lukasz-strama/jitter-daq/docs/jitter-hw.png

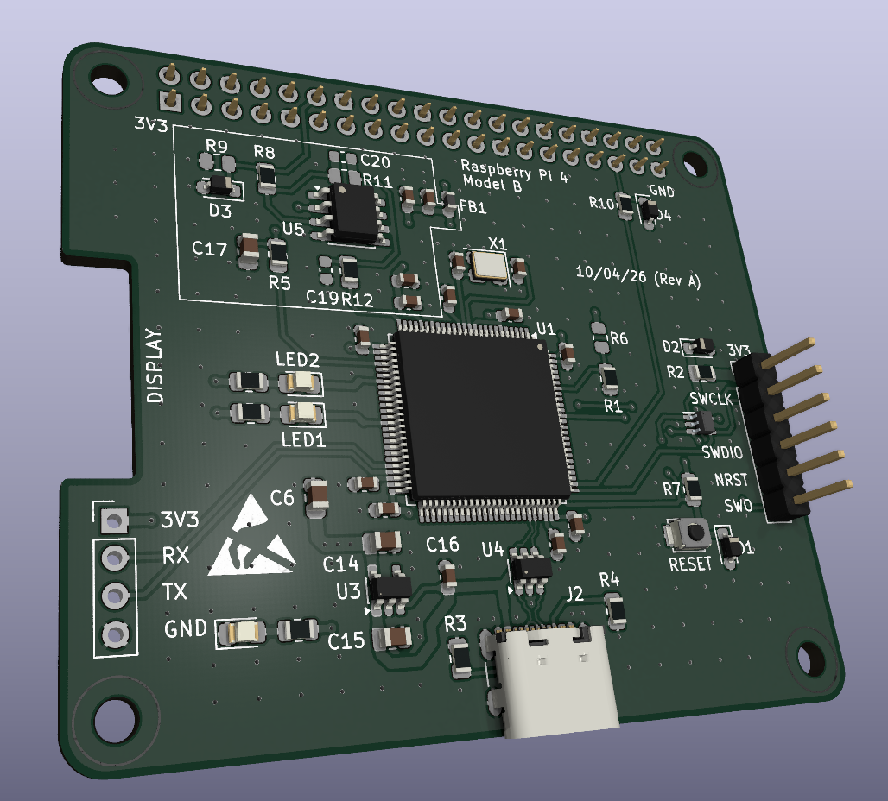
docs/jitter-hw.png
