lukasz-strama/jitter-daq/step/RF2-143-T-17-50-G.STEP

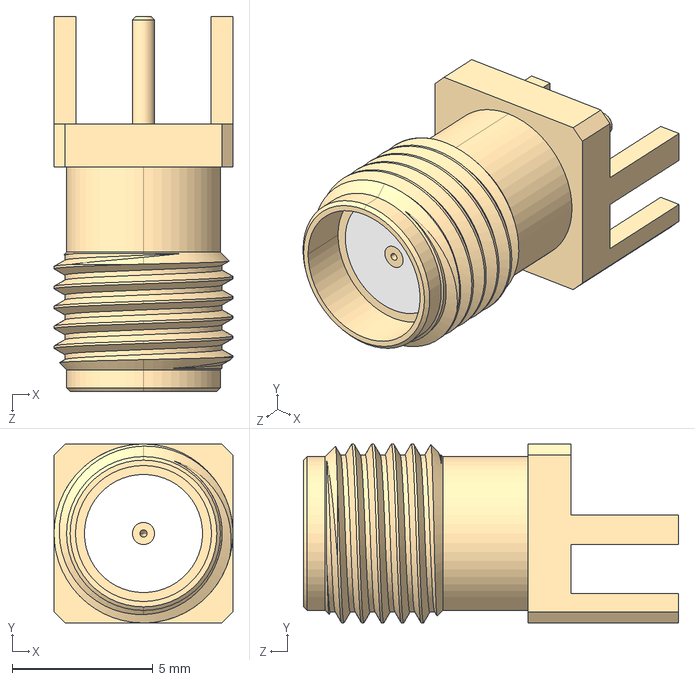
[picture p2: CAD file, 2026-10-07]
step/RF2-143-T-17-50-G.STEP
6.35 x 6.35 x 13.3 mm
