lukasz-strama/jitter-daq/step/ESDALC6V1W5.stp

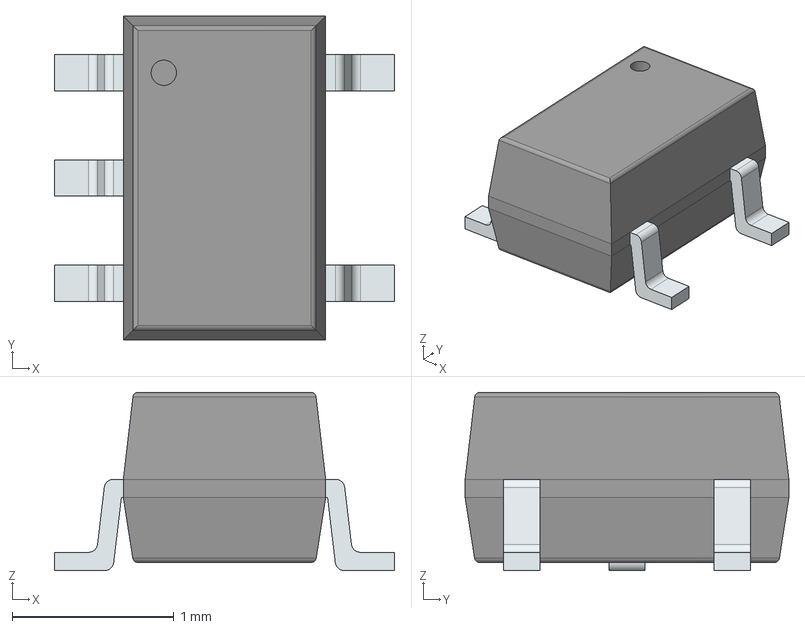
[picture p3: CAD file, 2026-10-07]
step/ESDALC6V1W5.stp
2.10 x 2.00 x 1.10 mm
PinsArrayL
PinsArrayR
