lukasz-strama/jitter-daq/docs/jitter-hw.pdf

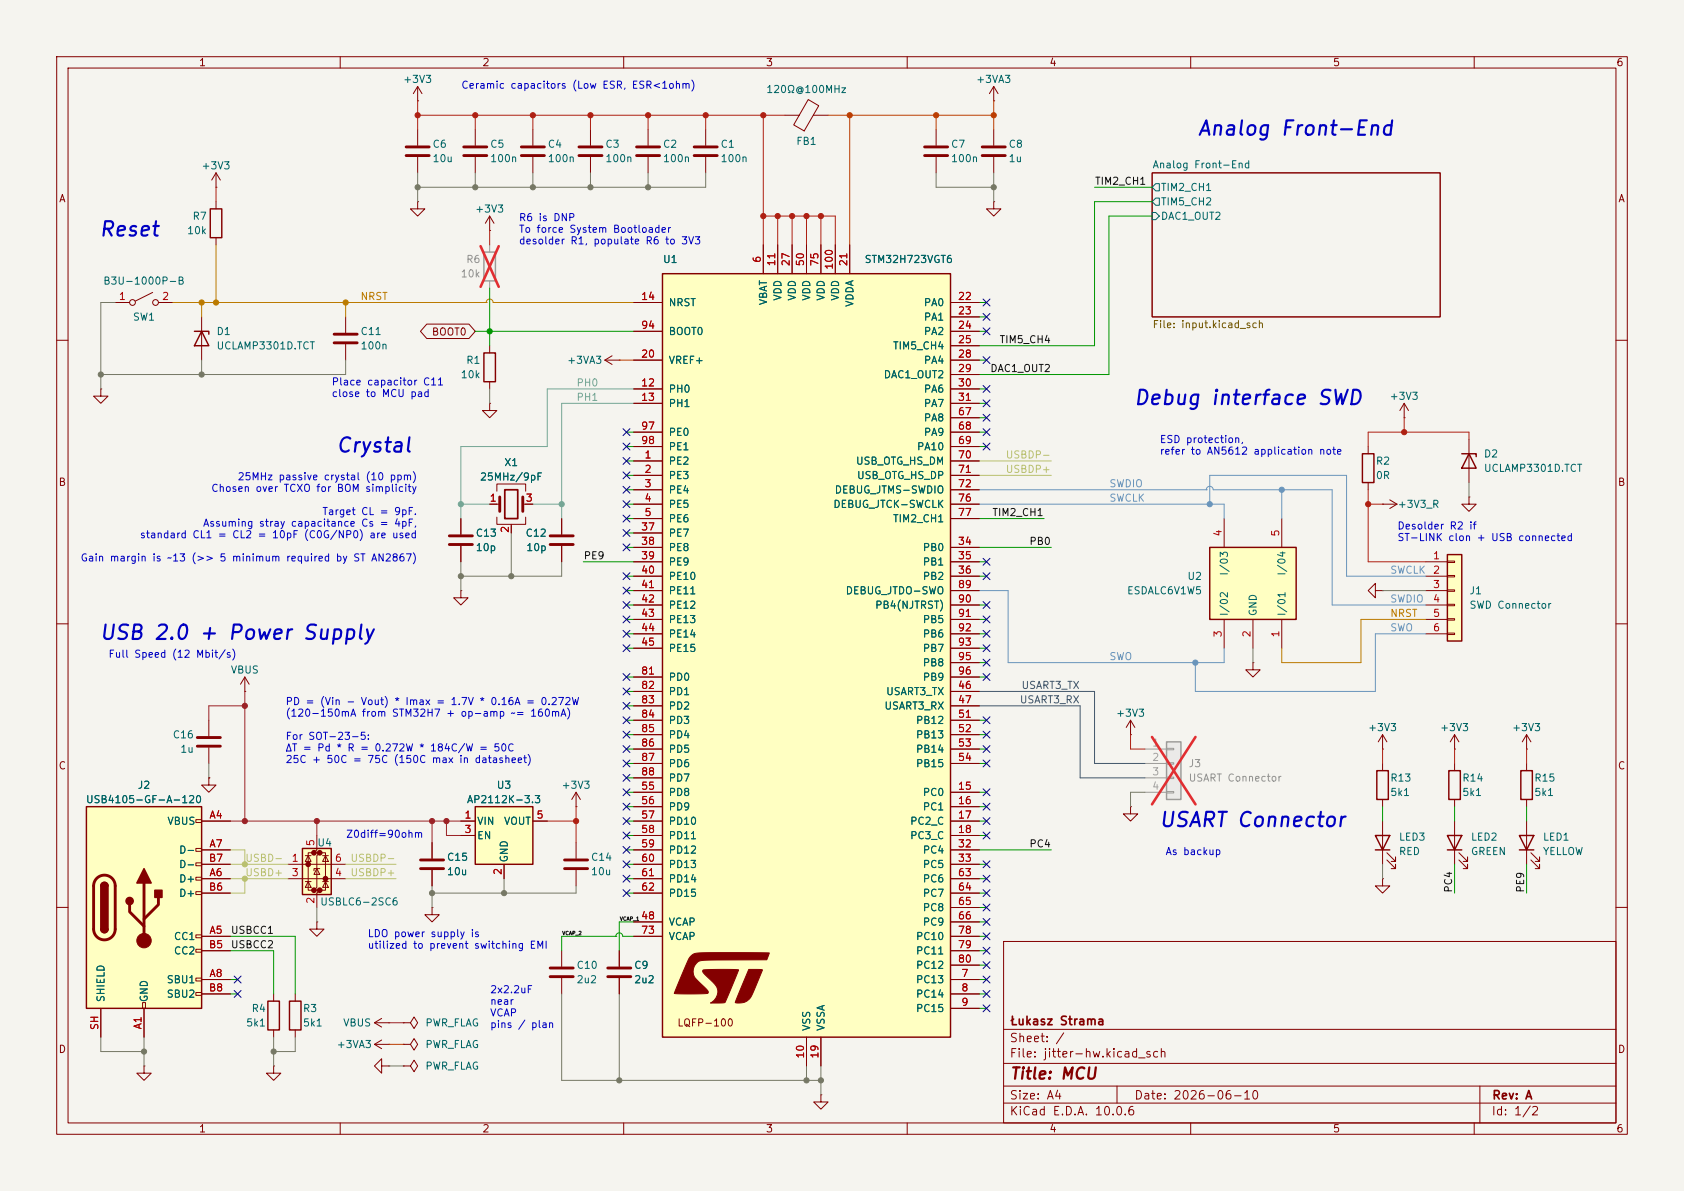
[picture p4: page 1]

Ceramic capacitors (Low ESR, ESR<1ohm)

To force System Bootloader desolder R1, populate R6 to 3V3 Place capacitor C11

25C + 50C = 75C (150C max in datasheet) 25MHz passive crystal (10 ppm) Chosen over TCXO for BOM simplicity

PD = (Vin - Vout) * Imax = 1.7V * 0.16A = 0.272W
(120-150mA from STM32H7 + op-amp ~= 160mA) For SOT-23-5: ΔT = Pd * R = 0.272W * 184C/W = 50C

Size: A4 | Rev: A
KiCad E.D.A. 10.0.6 | Id: 1/2

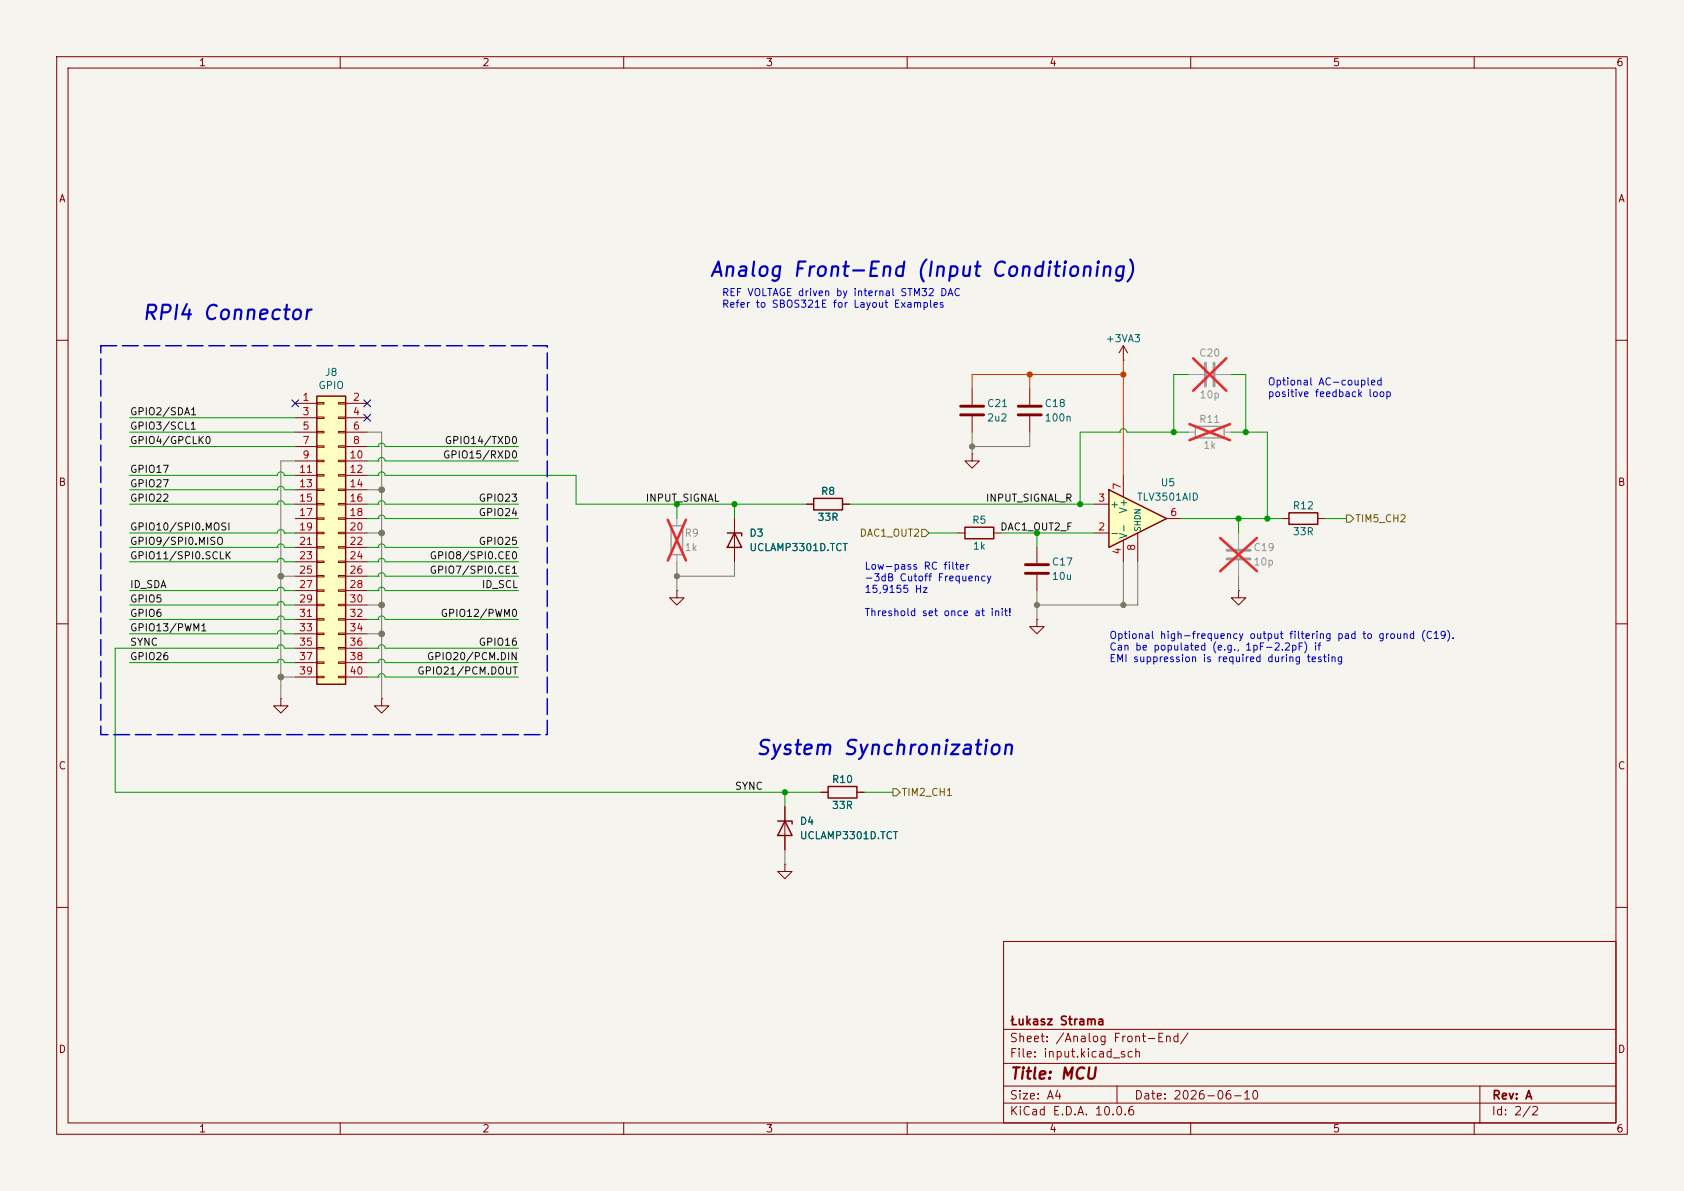
[picture p5: page 2]

Analog Front-End (Input Conditioning)

REF VOLTAGE driven by internal STM32 DAC
D3UCLAMP3301D.TCT R10

Refer to SBOS321E for Layout Examples RPI4 Connector

11 | 12
13 | 14
15 | 16

GPIO21/PCM.DOUT GPIO24 GPIO25 GPIO20/PCM.DIN

21 | 22
23 | 24
25 | 26
27 | 28
29 | 30
31 | 32
33 | 34
35 | 36
37 | 38
39 | 40

Low-pass RC filter -3dB Cutoff Frequency

Threshold set once at init! System Synchronization

Optional high-frequency output filtering pad to ground (C19). Can be populated (e.g., 1pF-2.2pF) if EMI suppression is required during testing

Łukasz Strama
Sheet: /Analog Front-End/
File: input.kicad_sch
Title: MCU

Size: A4 | Rev: A
KiCad E.D.A. 10.0.6 | Id: 2/2
