lukasz-strama/jitter-daq/jitter-hw.kicad_pcb

## KiCad design jitter-hw.kicad_pcb (2026-10-13)

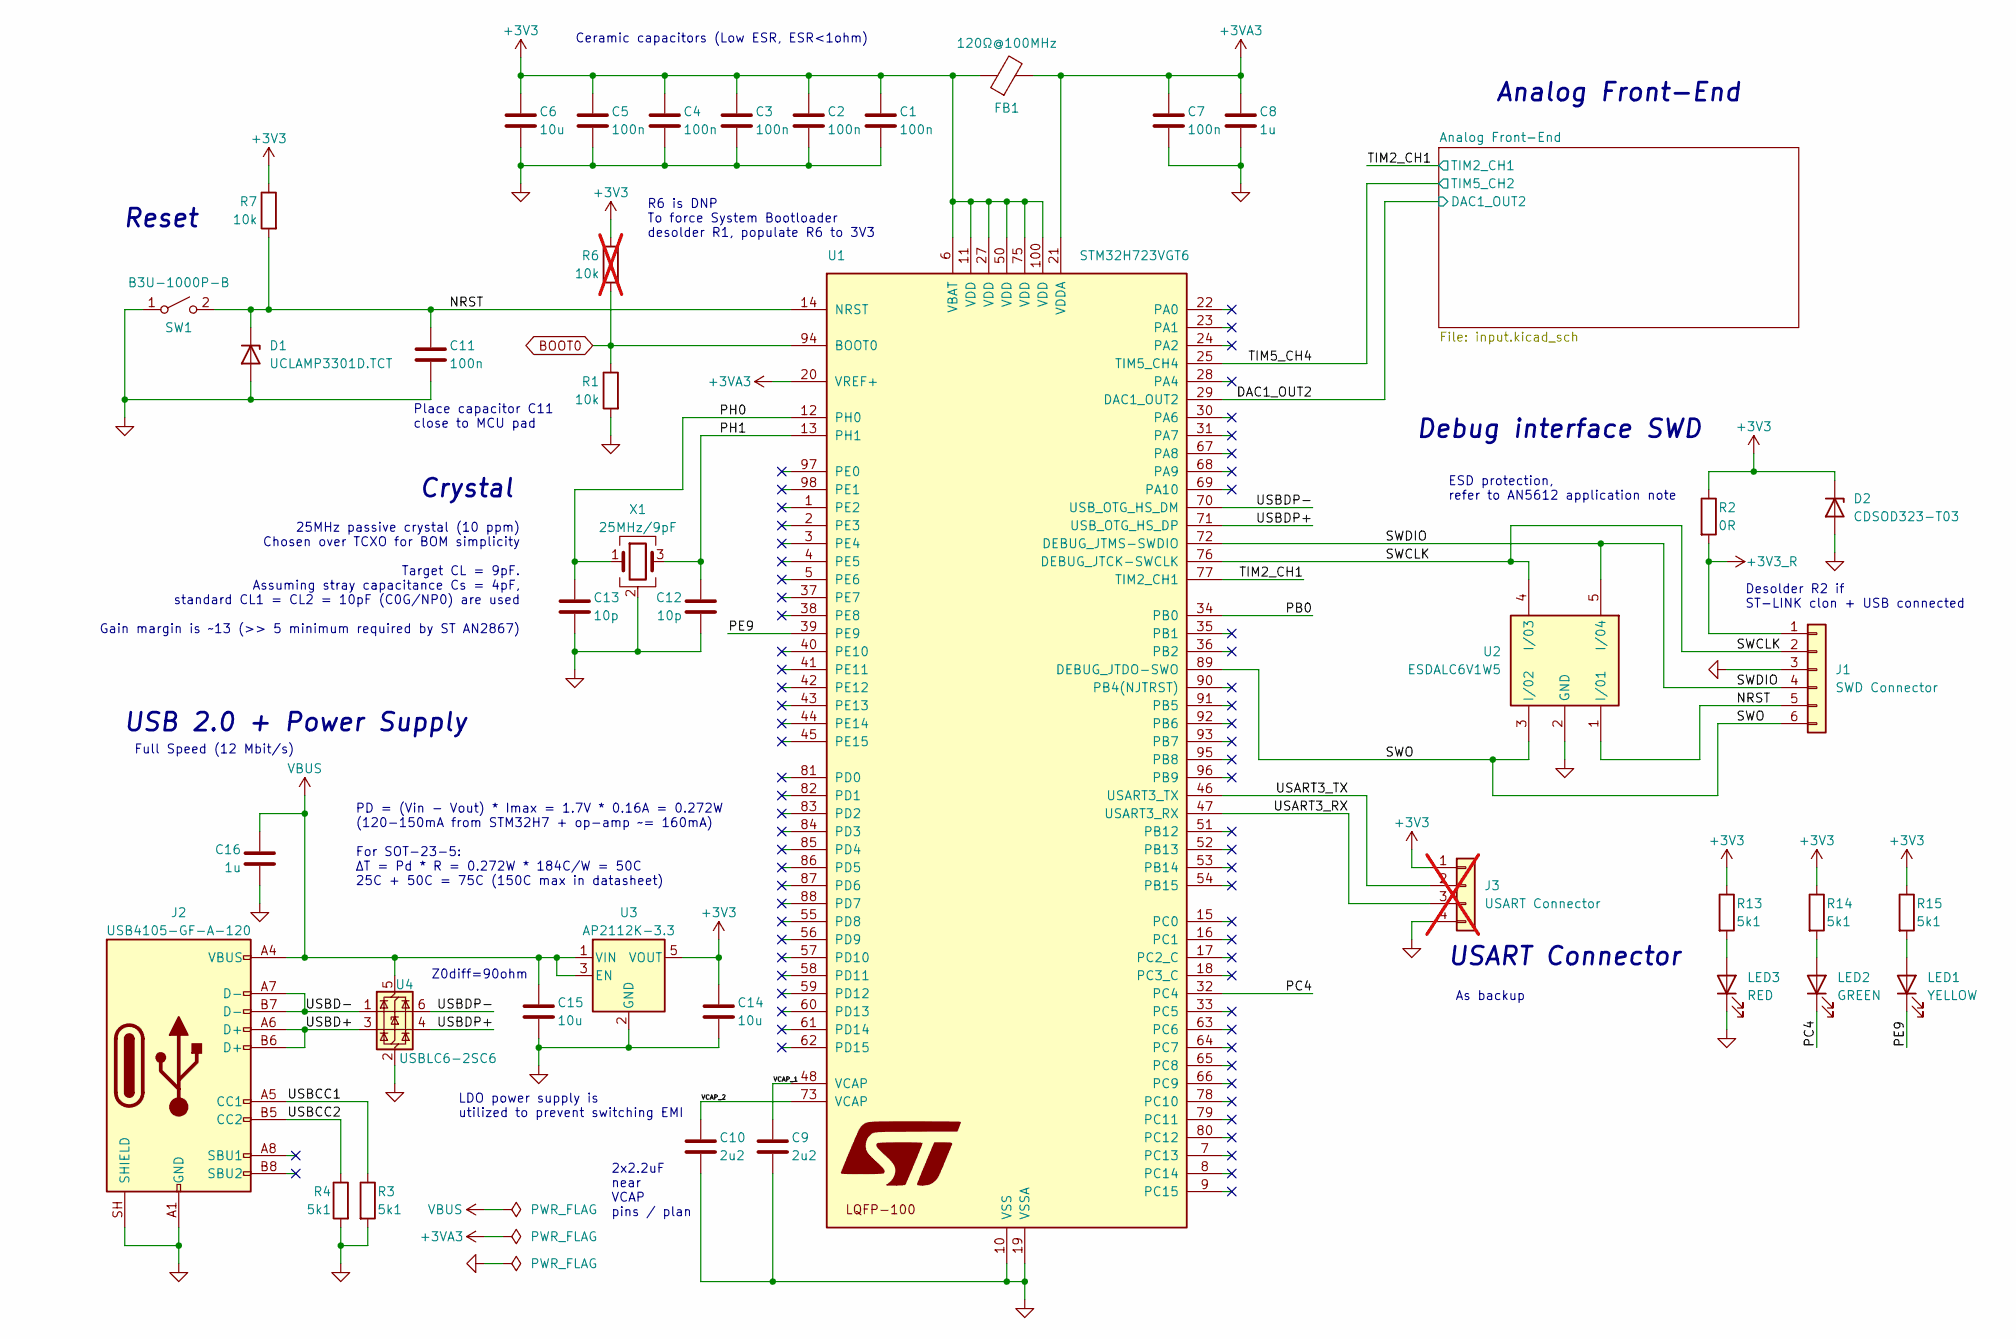
[picture p6: schematic jitter-hw.kicad_sch, MCU]

Parts:
C1, C2, C3, C4, C5, C7, C11: 100n; C_0603_1608Metric; Voltage 50V; Tolerance ±10%; MPN CL10B104KB8NNNC; DigiKey Part Number 1276-1000-1-ND
C6, C14, C15: 10u; C_0805_2012Metric; Voltage 25V; Tolerance ±10%; MPN CL21A106KAYNNNG; DigiKey Part Number 1276-6454-1-ND
C8, C16: 1u; C_0603_1608Metric; Voltage 25V; Tolerance ±10%; MPN CL10A105KA8NNNC; DigiKey Part Number 1276-1102-1-ND
C9, C10: 2u2; C_0603_1608Metric; Voltage 10V; Tolerance ±10%; MPN CL10B225KP8NNNC; DigiKey Part Number 1276-1134-1-ND
C12, C13: 10p; C_0603_1608Metric; Voltage 50V; Tolerance ±5%; MPN CL10C100JB8NNNC; DigiKey Part Number 1276-1027-1-ND
D1: UCLAMP3301D.TCT; D_SOD-323_HandSoldering; Voltage - Breakdown 3.5V; Voltage - Clamping 9.5V; MPN UCLAMP3301D.TCT; DigiKey Part Number UCLAMP3301DCT-ND
D2: CDSOD323-T03; D_SOD-323_HandSoldering; MPN CDSOD323-T03
FB1: 120Ω@100MHz; L_0603_1608Metric; Current Rating 2A; MPN BLM18PG121SN1D; DigiKey Part Number 490-1037-1-ND
J1: SWD Connector; PinHeader_1x06_P2.54mm_Vertical
J2: USB4105-GF-A-120; USB_C_Receptacle_GCT_USB4105-xx-A_16P_TopMnt_Horizontal; Voltage - Rated 48VDC; MPN USB4105-GF-A-120; DigiKey Part Number 2073-USB4105-GF-A-120CT-ND
J3: USART Connector; PinHeader_1x04_P2.54mm_Vertical; not fitted
LED1: YELLOW; LED_0805_2012Metric_Pad1.15x1.40mm_HandSolder; MPN KP-2012SYC
LED2: GREEN; LED_0805_2012Metric_Pad1.15x1.40mm_HandSolder; MPN KP-2012SGC
LED3: RED; LED_0805_2012Metric_Pad1.15x1.40mm_HandSolder; MPN KP-2012SURCK
R1, R7: 10k; R_0805_2012Metric; Tolerance ±1%; MPN RC0805FR-0710K; DigiKey Part Number 311-10.0KCRCT-ND
R2: 0R; R_0805_2012Metric; Tolerance Jumper; MPN RC0805FR-070RL; DigiKey Part Number 311-0.0CRCT-ND
R3, R4, R13, R14, R15: 5k1; R_0805_2012Metric; Tolerance ±1%; MPN RC0805FR-075K1; DigiKey Part Number 311-5.10KCRCT-ND
R6: 10k; R_0805_2012Metric; Tolerance ±1%; MPN RC0805FR-0710K; DigiKey Part Number 311-10.0KCRCT-ND; not fitted
SW1: B3U-1000P-B; SW_SPST_B3U-1000P; Contact Rating @ Voltage 0.05A @ 12VDC; MPN B3U-1000P-B; DigiKey Part Number SW1143CT-ND
U1: STM32H723VGT6; LQFP-100_14x14mm_P0.5mm; Voltage 1.71V ~ 3.6V; MPN STM32H723VGT6; DigiKey Part Number 497-STM32H723VGT6TRCT-ND
U2: ESDALC6V1W5; SOT65P210X110-5N; Voltage - Reverse Stand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 3V; Voltage - Clamping 9.5V; MPN ESDALC6V1W5; DigiKey Part Number 497-7231-1-ND
U3: AP2112K-3.3; SOT-23-5; Voltage - Input 6V; Voltage - Output 3.3V; MPN AP2112K-3.3TRG1; DigiKey Part Number AP2112K-3.3TRG1DICT-ND
U4: USBLC6-2SC6; SOT-23-6; Voltage - Reverse Stand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 5.25V; Voltage - Breakdown 6V; MPN USBLC6-2SC6; DigiKey Part Number 497-11882-1-ND
X1: 25MHz/9pF; Crystal_SMD_3225-4Pin_3.2x2.5mm; MPN 3225-25M-SR

Connections:
+3V3: C1.1, C2.1, C3.1, C4.1, C5.1, C6.1, C14.1, D2.1 (K), FB1.1, J3.1, R2.1, R6.1, R7.1, R13.1, R14.1, R15.1, U1.6 (VBAT), U1.11 (VDD), U1.27 (VDD), U1.50 (VDD), U1.75 (VDD), U1.100 (VDD), U3.5 (VOUT)
+3V3_R: J1.1, R2.2
+3VA3: C7.1, C8.1, FB1.2, U1.20 (VREF+), U1.21 (VDDA); also elsewhere on the board
/DAC1_OUT2: U1.29 (DAC1_OUT2); also elsewhere on the board
/NRST: C11.1, D1.1 (K), J1.5, R7.2, SW1.2 (B), U1.14 (NRST), U2.1 (I/01)
/PB0: U1.34 (PB0)
/PC4: LED2.1 (K), U1.32 (PC4)
/PE9: LED1.1 (K), U1.39 (PE9)
/PH0: C13.1, U1.12 (PH0), X1.1
/PH1: C12.1, U1.13 (PH1), X1.3
/SWCLK: J1.2, U1.76 (DEBUG_JTCK-SWCLK), U2.4 (I/03)
/SWDIO: J1.4, U1.72 (DEBUG_JTMS-SWDIO), U2.5 (I/04)
/SWO: J1.6, U1.89 (DEBUG_JTDO-SWO), U2.3 (I/02)
/TIM2_CH1: U1.77 (TIM2_CH1); also elsewhere on the board
/TIM5_CH4: U1.25 (TIM5_CH4); also elsewhere on the board
/USART3_RX: J3.3, U1.47 (USART3_RX)
/USART3_TX: J3.2, U1.46 (USART3_TX)
/USBCC1: J2.A5 (CC1), R3.1
/USBCC2: J2.B5 (CC2), R4.1
/USBD+: J2.A6 (D+), J2.B6 (D+), U4.3 (I/O2)
/USBD-: J2.A7 (D-), J2.B7 (D-), U4.1 (I/O1)
/USBDP+: U1.71 (USB_OTG_HS_DP), U4.4 (I/O2)
/USBDP-: U1.70 (USB_OTG_HS_DM), U4.6 (I/O1)
/VCAP_1: C9.1, U1.48 (VCAP)
/VCAP_2: C10.1, U1.73 (VCAP)
BOOT0: R1.1, R6.2, U1.94 (BOOT0)
GND: C1.2, C2.2, C3.2, C4.2, C5.2, C6.2, C7.2, C8.2, C9.2, C10.2, C11.2, C12.2, C13.2, C14.2, C15.2, C16.2, D1.2 (A), D2.2 (A), J1.3, J2.A1 (GND), J2.A12 (GND), J2.B1 (GND), J2.B12 (GND), J2.SH (SHIELD), J3.4, LED3.1 (K), R1.2, R3.2, R4.2, SW1.1 (A), U1.10 (VSS), U1.19 (VSSA), U1.26 (VSS), U1.49 (VSS), U1.74 (VSS), U1.99 (VSS), U2.2 (GND), U3.2 (GND), U4.2 (GND), X1.2 (G), X1.4 (G); also elsewhere on the board
unnamed: LED1.2 (A), R15.2
unnamed: LED2.2 (A), R14.2
unnamed: LED3.2 (A), R13.2
VBUS: C15.1, C16.1, J2.A4 (VBUS), J2.A9 (VBUS), J2.B4 (VBUS), J2.B9 (VBUS), U3.1 (VIN), U3.3 (EN), U4.5 (VBUS)

Notes on the sheet:
R6 is DNP To force System Bootloader desolder R1, populate R6 to 3V3
ESD protection, refer to AN5612 application note
USART Connector
As backup
Desolder R2 if ST-LINK clon + USB connected
Place capacitor C11 close to MCU pad
2x2.2uF near VCAP pins / plan
PD = (Vin - Vout) * Imax = 1.7V * 0.16A = 0.272W (120-150mA from STM32H7 + op-amp ~= 160mA) For SOT-23-5: ΔT = Pd * R = 0.272W * 184C/W = 50C 25C + 50C = 75C (150C max in datasheet)
Ceramic capacitors (Low ESR, ESR<1ohm)
LDO power supply is utilized to prevent switching EMI
USB 2.0 + Power Supply
Full Speed (12 Mbit/s)
Z0diff=90ohm
Crystal
Reset
Debug interface SWD
25MHz passive crystal (10 ppm) Chosen over TCXO for BOM simplicity Target CL = 9pF. Assuming stray capacitance Cs = 4pF, standard CL1 = CL2 = 10pF (C0G/NP0) are used Gain margin is ~13 (>> 5 minimum required by ST AN2867)
Analog Front-End

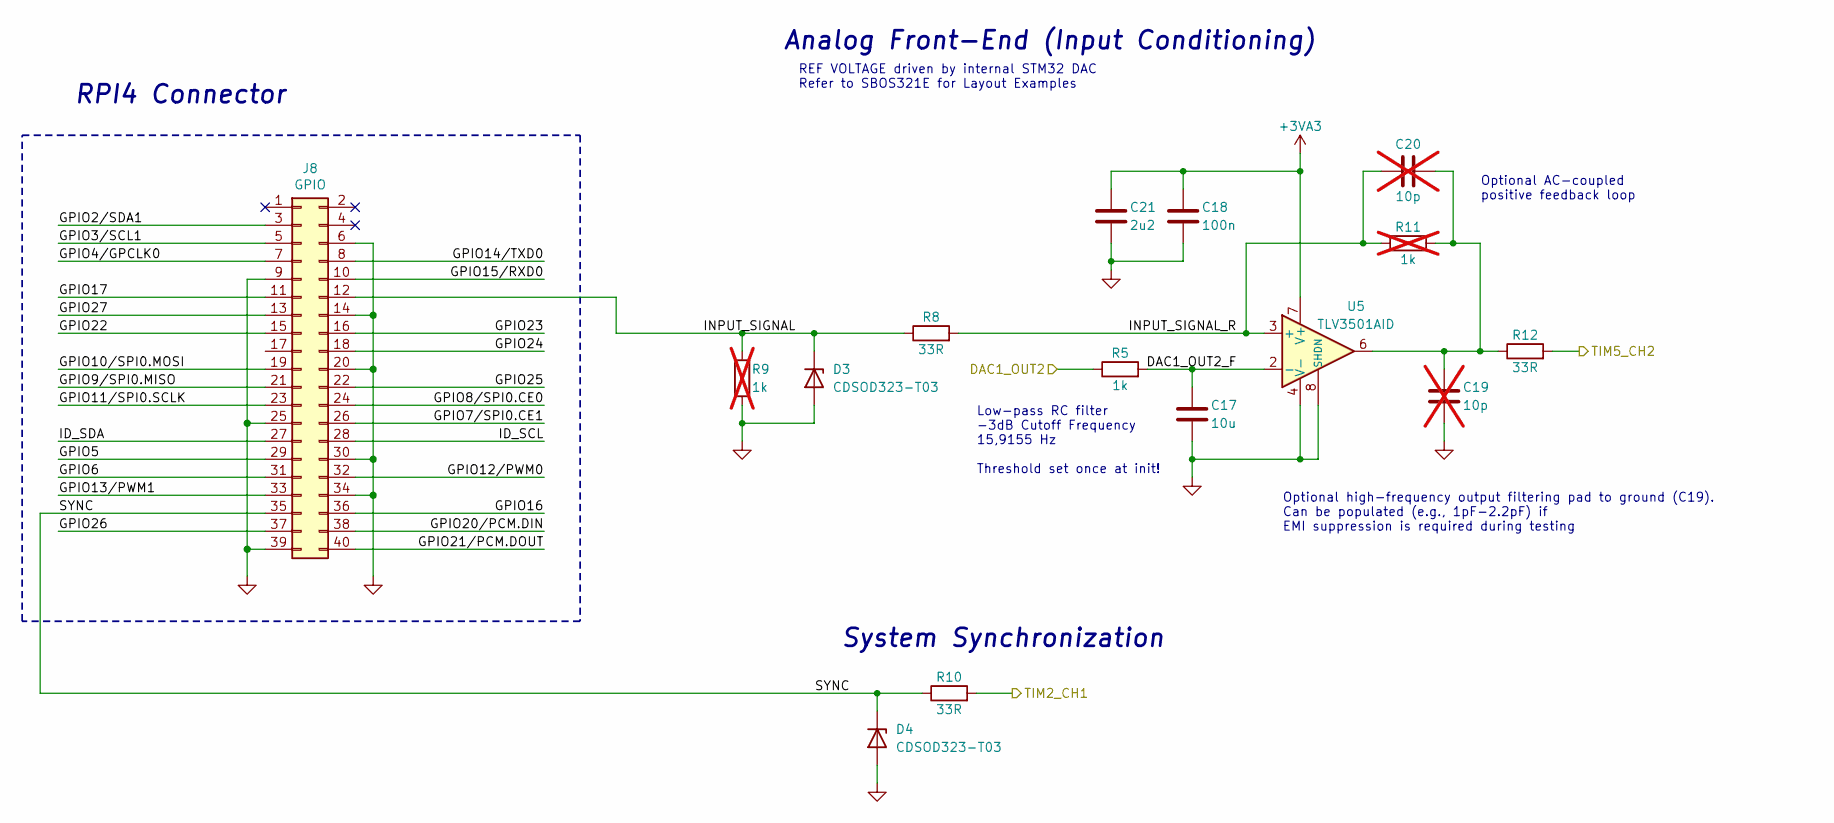
[picture p7: schematic input.kicad_sch, MCU]

Parts:
C17: 10u; C_0805_2012Metric; Voltage 25V; Tolerance ±10%; MPN CL21A106KAYNNNG; DigiKey Part Number 1276-6454-1-ND
C18: 100n; C_0603_1608Metric; Voltage 50V; Tolerance ±10%; MPN CL10B104KB8NNNC; DigiKey Part Number 1276-1000-1-ND
C19, C20: 10p; C_0603_1608Metric; Voltage 50V; Tolerance ±5%; MPN CL10C100JB8NNNC; DigiKey Part Number 1276-1027-1-ND; not fitted
C21: 2u2; C_0603_1608Metric; Voltage 10V; Tolerance ±10%; MPN CL10B225KP8NNNC; DigiKey Part Number 1276-1134-1-ND
D3, D4: CDSOD323-T03; D_SOD-323_HandSoldering; MPN CDSOD323-T03
J8: GPIO; PinSocket_2x20_P2.54mm_Vertical
R5: 1k; R_0805_2012Metric; Tolerance ±1%; MPN RC0805FR-071K; DigiKey Part Number YAG1321CT-ND
R8, R10, R12: 33R; R_0805_2012Metric; Tolerance ±1%; MPN RC0805FR-0733RL; DigiKey Part Number 311-33.0CRCT-ND
R9, R11: 1k; R_0805_2012Metric; Tolerance ±1%; MPN RC0805FR-071K; DigiKey Part Number YAG1321CT-ND; not fitted
U5: TLV3501AID; SOIC-8_3.9x4.9mm_P1.27mm; Voltage - Input Offset 6.5mV @ 5.5V; MPN TLV3501AID; DigiKey Part Number 296-17921-5-ND

Connections:
+3VA3: C18.1, C21.1, U5.7 (V+); also elsewhere on the board
/Analog Front-End/DAC1_OUT2_F: C17.1, R5.2, U5.2 (-)
/Analog Front-End/GPIO2/SDA1: J8.3
/Analog Front-End/GPIO3/SCL1: J8.5
/Analog Front-End/GPIO4/GPCLK0: J8.7
/Analog Front-End/GPIO5: J8.29
/Analog Front-End/GPIO6: J8.31
/Analog Front-End/GPIO7/SPI0.CE1: J8.26
/Analog Front-End/GPIO8/SPI0.CE0: J8.24
/Analog Front-End/GPIO9/SPI0.MISO: J8.21
/Analog Front-End/GPIO10/SPI0.MOSI: J8.19
/Analog Front-End/GPIO11/SPI0.SCLK: J8.23
/Analog Front-End/GPIO12/PWM0: J8.32
/Analog Front-End/GPIO13/PWM1: J8.33
/Analog Front-End/GPIO14/TXD0: J8.8
/Analog Front-End/GPIO15/RXD0: J8.10
/Analog Front-End/GPIO16: J8.36
/Analog Front-End/GPIO17: J8.11
/Analog Front-End/GPIO20/PCM.DIN: J8.38
/Analog Front-End/GPIO21/PCM.DOUT: J8.40
/Analog Front-End/GPIO22: J8.15
/Analog Front-End/GPIO23: J8.16
/Analog Front-End/GPIO24: J8.18
/Analog Front-End/GPIO25: J8.22
/Analog Front-End/GPIO26: J8.37
/Analog Front-End/GPIO27: J8.13
/Analog Front-End/ID_SCL: J8.28
/Analog Front-End/ID_SDA: J8.27
/Analog Front-End/INPUT_SIGNAL: D3.1 (K), J8.12, R8.1, R9.1
/Analog Front-End/INPUT_SIGNAL_R: C20.1, R8.2, R11.1, U5.3 (+)
/Analog Front-End/SYNC: D4.1 (K), J8.35, R10.1
/DAC1_OUT2: R5.1; also elsewhere on the board
/TIM2_CH1: R10.2; also elsewhere on the board
/TIM5_CH4: R12.2; also elsewhere on the board
GND: C17.2, C18.2, C19.2, C21.2, D3.2 (A), D4.2 (A), J8.6, J8.9, J8.14, J8.20, J8.25, J8.30, J8.34, J8.39, R9.2, U5.4 (V-), U5.8 (SHDN); also elsewhere on the board
unnamed: C19.1, C20.2, R11.2, R12.1, U5.6

Notes on the sheet:
REF VOLTAGE driven by internal STM32 DAC Refer to SBOS321E for Layout Examples
Optional high-frequency output filtering pad to ground (C19). Can be populated (e.g., 1pF-2.2pF) if EMI suppression is required during testing
System Synchronization
RPI4 Connector
Low-pass RC filter -3dB Cutoff Frequency 15,9155 Hz Threshold set once at init!
Analog Front-End (Input Conditioning)
Optional AC-coupled positive feedback loop

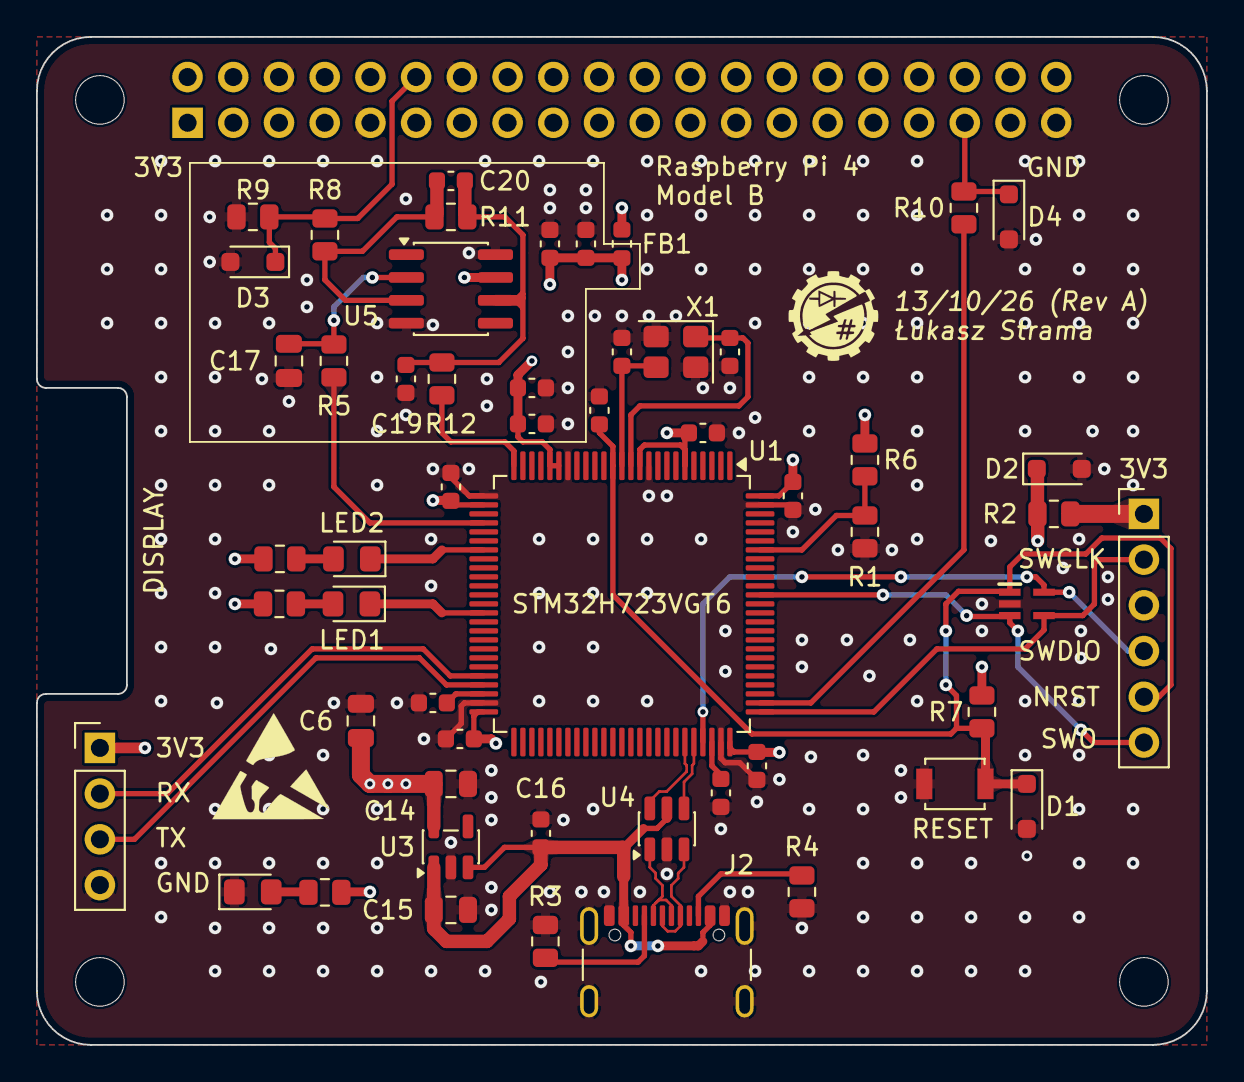
[picture p8: board jitter-hw.kicad_pcb from above]

Board: 4 copper layers, 65.0 x 56.0 mm, 59 parts (1 on the bottom side), 35 nets.

Other parts of the board:
MH1, MH2, MH3, MH4: MountingHole_2.7mm_M2.5
