lukasz-strama/jitter-daq/(commit log)

2026-10-07 rev. A
    [ESDALC6V1W5.stp, RF2-143-T-17-50-G.STEP, input.kicad_sch, jitter-hw.kicad_pcb, jitter-hw.kicad_sch]
2026-10-08 gen BOM
